endurodave/OBDII-Adapter-Software/src/Vehicle.h

//------------------------------------------------------------------------------
// File: Vehicle
//
// Purpose: Vehicle communication and parsing routines. 
//
// Change History:
// Date		Author		Description
//          Lafreniere	Created
//------------------------------------------------------------------------------
#ifndef VEHICLE_H
#define VEHICLE_H

void VehSendRecv();

#endif
